SmartLogicUA/GSM-Ringer-Pro/images/gsm_ringer_pro6.jpg

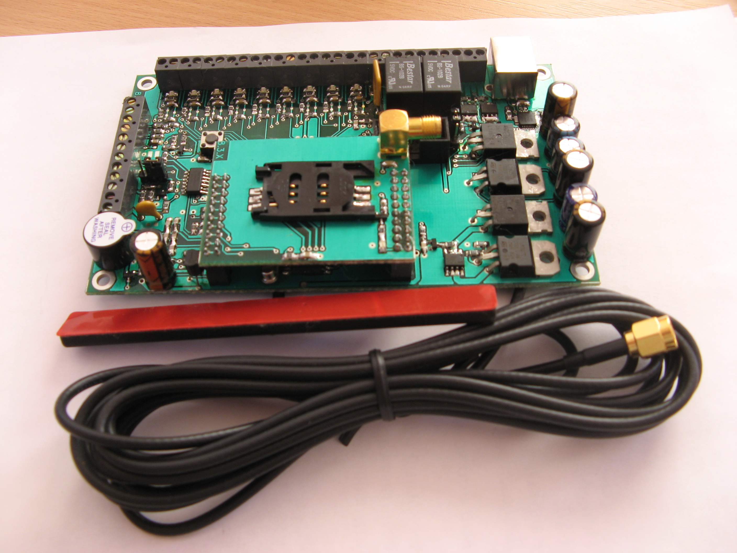
images/gsm_ringer_pro6.jpg
