SmartLogicUA/GSM-Ringer-Pro/images/gsm_ringer_pro3.jpg

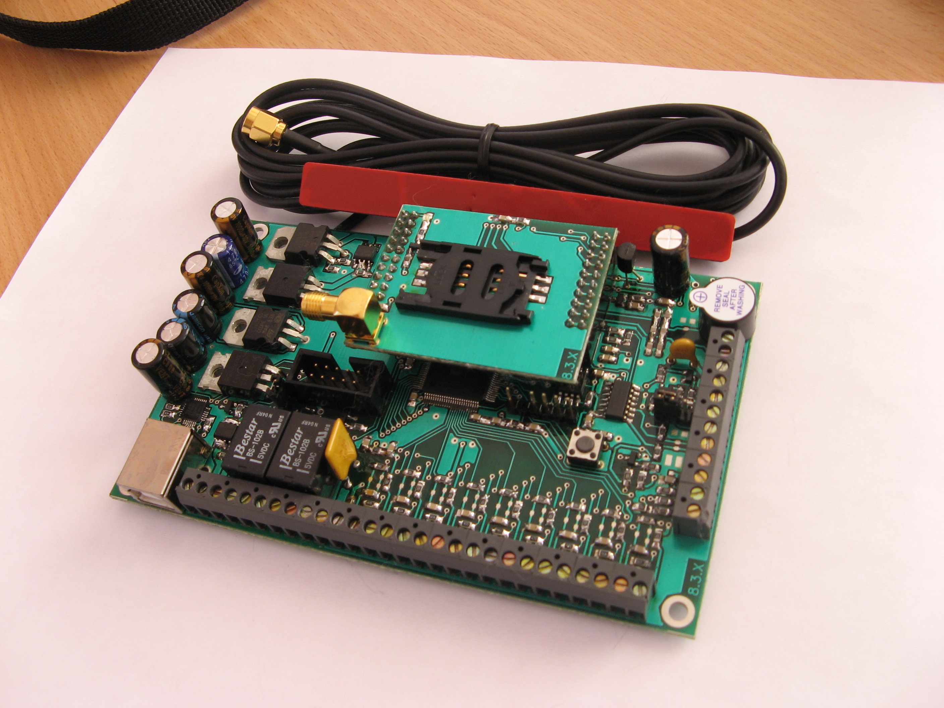
images/gsm_ringer_pro3.jpg
