SmartLogicUA/GSM-Ringer-Pro/bin/gsm_ringer_pro_summary_v1_0_140410.pdf

SMART LOGIC | GSM Ringer Pro v1.0

Устройство GSM оповещения «GSM Ringer Pro» прошивка GSM Ringer Pro v1.0

Контроллер «GSM Ringer Pro» предназначен для оповещения о проникновении посторонних лиц на контролируемые объекты (квартиры, офисы, дачи и др.), посредством дозвона или отправления SMS на указанные телефонные номера по GSM каналу. Контроллер предназначен
для | установки | на | отдельный | объект | и | является
полнофункциональным | устройством. | Он | позволяет
осуществлять контроль доступа на объект при помощи

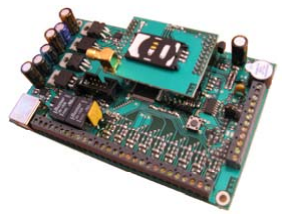
[picture p3: figure]

считывателя proximity-карт и удаленное управление сопрягаемыми с ним устройствами с мобильного терминала при помощи DTMF.
Для построения системы оповещения достаточно применение данного контроллера, датчиков и устройства электропитания. Конструкция контроллера позволяет использовать любые типы датчиков, имеющих нормально-замкнутый или нормально-разомкнутый контакты. При подключении датчиков используются оконечные резисторы. Контроллер является адаптивным устройством с гибкой системой настроек. Для осуществления настройки используется ПК и специализированное программное обеспечение.

Технические возможности «GSM Ringer Pro»:

- работа в сетях GSM – 900/1800/1900;
- световая индикация наличия покрытия оператора связи GSM;
- световая индикация состояния каждой зоны (на плате контроллера и выносная);
- акустическая и световая индикация постановки контроллера в активный режим;
- проверка счета, пополнение счета и т.д.;
- выбор способа оповещения (дозвон и/или сообщение);
- акустический контроль помещения с помощью выносного микрофона;
- активация/деактивация при помощи кнопки, считывателя proximity-карт, посредством мобильного терминала с использованием DTMF;
- максимальное количество прописанных в системе proximity-карточек -20;
- установка времени отсрочки активации контроллера от 1 до 255с;
- установка времени отсрочки оповещения от 1 до 255с;
- программное исключение неиспользуемых зон;
- управление исполнительными устройствами при помощи релейных выходов и выходов с открытым коллектором;
- настройка срабатывания релейных выходов и выходов с открытым коллектором по срабатыванию зон, считывателю, кнопке, получении команды с мобильного терминала с использованием DTMF;
- установка задержки срабатывания и времени удержания релейных выходов и выходов с открытым коллектором;
- максимальное количество телефонных номеров пользователей - 5;
- конфигурирование при помощи SMS сообщения и через USB-порт;
- обновление программного обеспечения контроллера через USB-порт;
- наличие голосового меню;
- установка заводских настроек.

Технические характеристики «GSM Ringer Pro»:

support@smartlogic.com.ua | www.smartlogic.com.ua

SMART LOGIC | GSM Ringer Pro v1.0
- напряжение питания постоянного тока 12В;
- потребляемый ток в дежурном режиме менее 0,15А (без учета потребления считывателя proximity-карт) ;
- интерфейс для подключения считывателя proximity-карт – Wiegand-26;
- максимальное сопротивление постоянному току контролируемого шлейфа не более 150 Ом;
- количество контролируемых шлейфов - 8;
- сопротивление/мощность оконечного резистора - (2,2 ± 5%)/0,125 кОм/Вт;
- количество релейных выходов – 2;
- количество выходов с открытым коллектором -2;
- максимальное коммутируемое релейным выходом переменное/постоянное напряжение – 125/25В;
- максимальный коммутируемый релейным выходом переменный/постоянный ток – 1/2А;
- максимальное коммутируемое выходом с открытым коллектором постоянное напряжение – 15В;
- максимальный коммутируемый выходом с открытым коллектором постоянный ток – 1А;
- диапазон рабочих температур -20 … +60С;
- масса контроллера не более 350г.
| «GSM Ringer Pro - Конфигуратор» предназначен для конфигурирования устройства GSM оповещения «GSM

Ringer Pro».

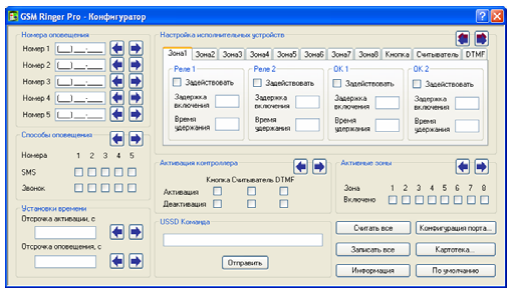
[picture p4: figure]

Возможности:
- установка номеров абонентов;
- установка времени отсрочки активации;
- установка времени отсрочки оповещения;
- выбор способов оповещения;
- выбор активных зон;
- установка срабатывания релейных выходов и выходов с открытым коллектором по внешним событиям;
- установка задержки срабатывания и времени удержания релейных выходов и выходов с открытым коллектором;
- прописывание/стирание proximity-карт в контроллер;
- установка параметров по умолчанию;
- выполнение USSD команд.

В состав «GSM Ringer Pro» входят:
- устройство «GSM Ringer Pro»;
- GSM антенна;
- модуль индикации;
- программное обеспечение.
support@smartlogic.com.ua | www.smartlogic.com.ua
