SmartLogicUA/GSM-Ringer-Pro/images/gsm_ringer_pro1.jpg

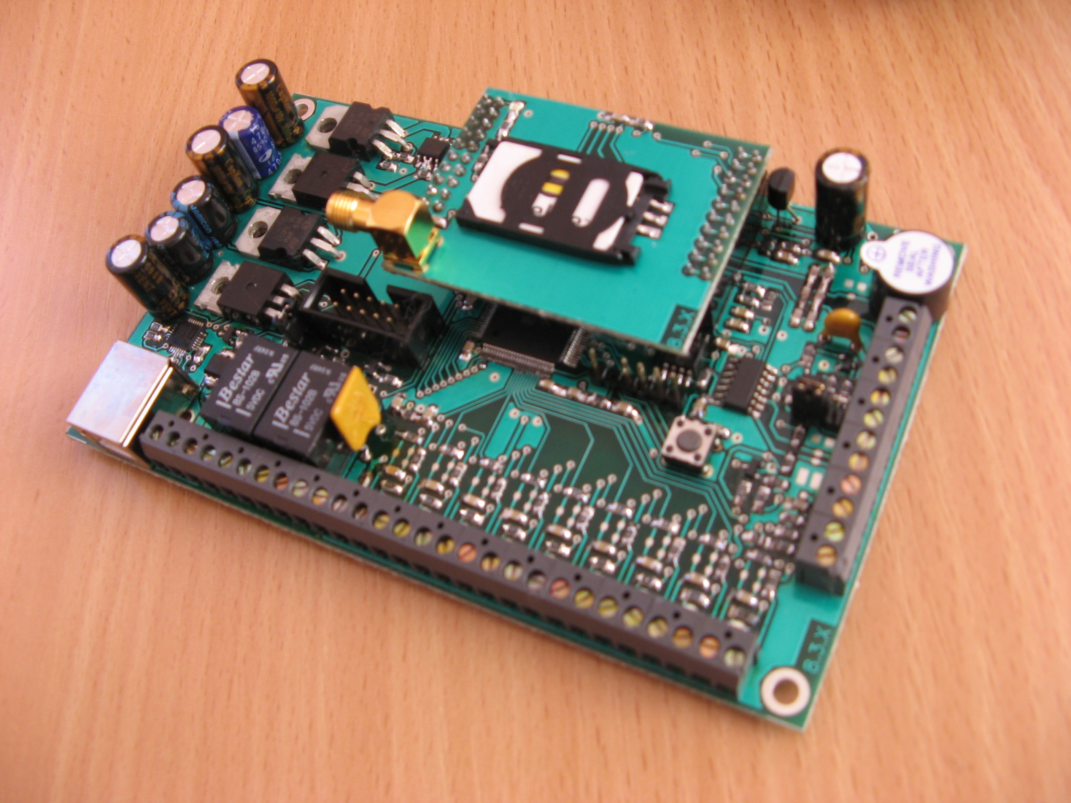
images/gsm_ringer_pro1.jpg
