SmartLogicUA/GSM-Ringer-Pro/images/gsm_ringer_pro2.jpg

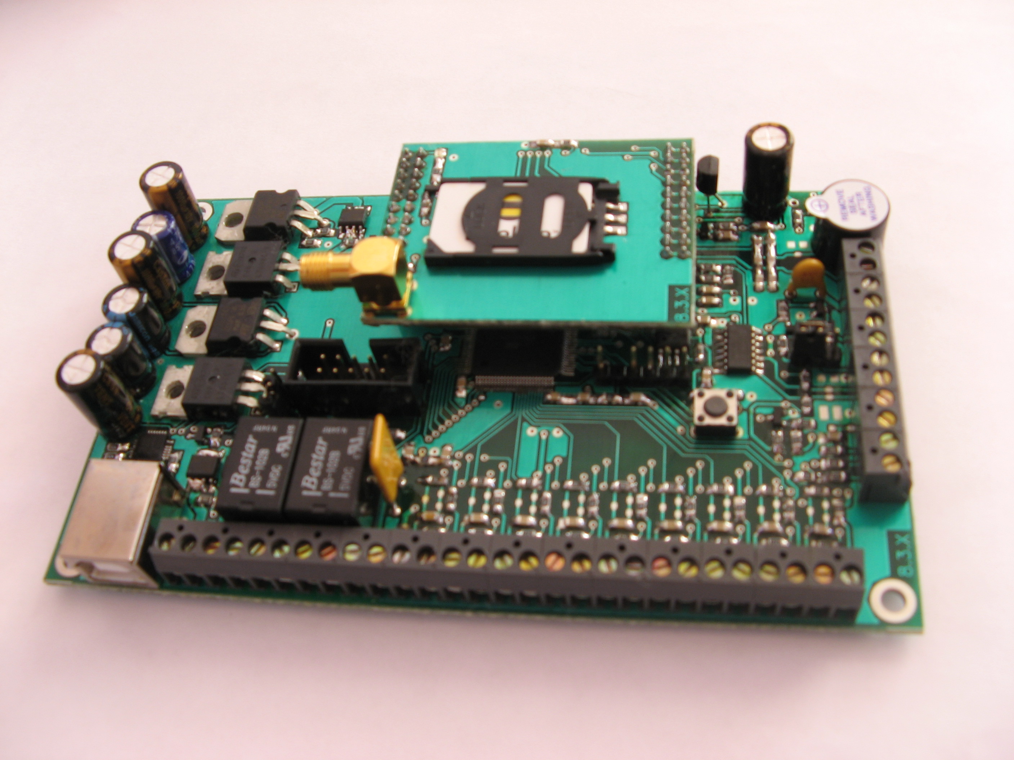
images/gsm_ringer_pro2.jpg
