SmartLogicUA/GSM-Ringer-Pro/images/gsm_ringer_pro4.jpg

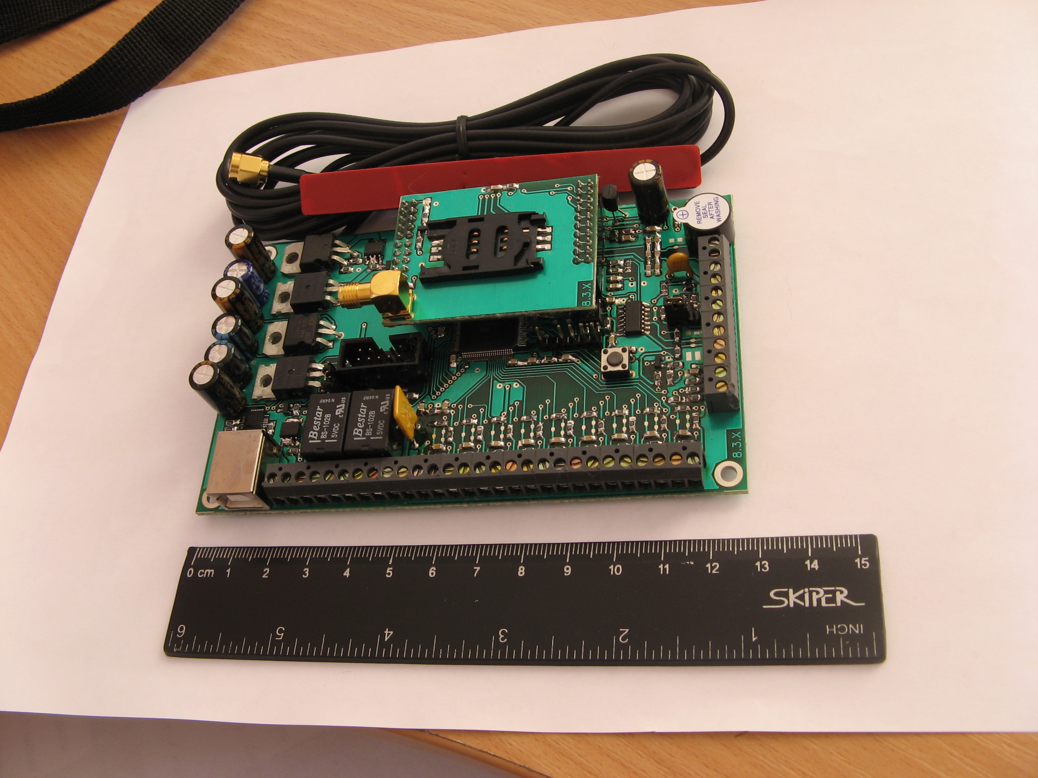
images/gsm_ringer_pro4.jpg
