SmartLogicUA/GSM-Ringer-Pro/images/gsm_ringer_pro5.jpg

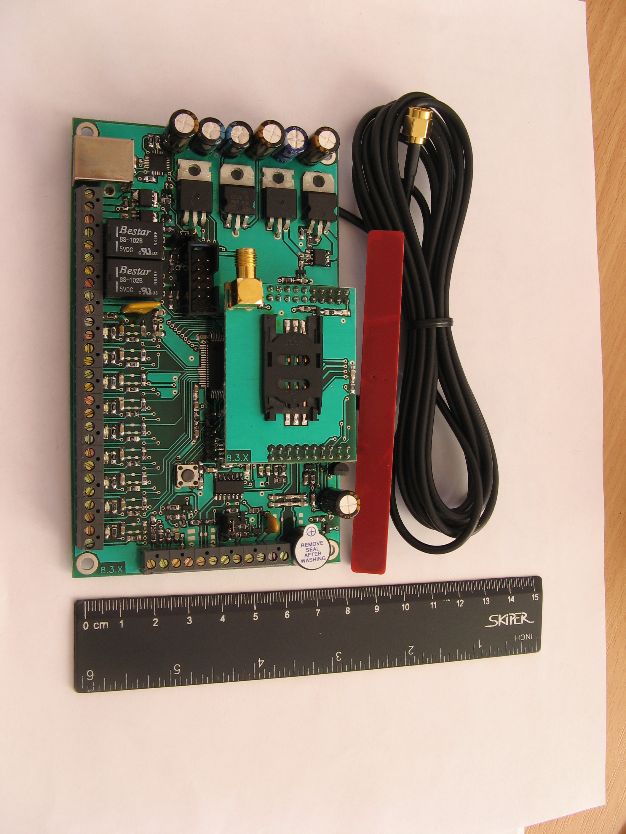
images/gsm_ringer_pro5.jpg
