SmartLogicUA/GSM-Ringer-Pro/images/gsm_ringer_pro.jpg

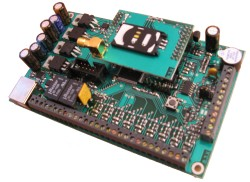
images/gsm_ringer_pro.jpg
