SmartLogicUA/GSM-Ringer-Pro/images/gsm_ringer_pro_box1.jpg

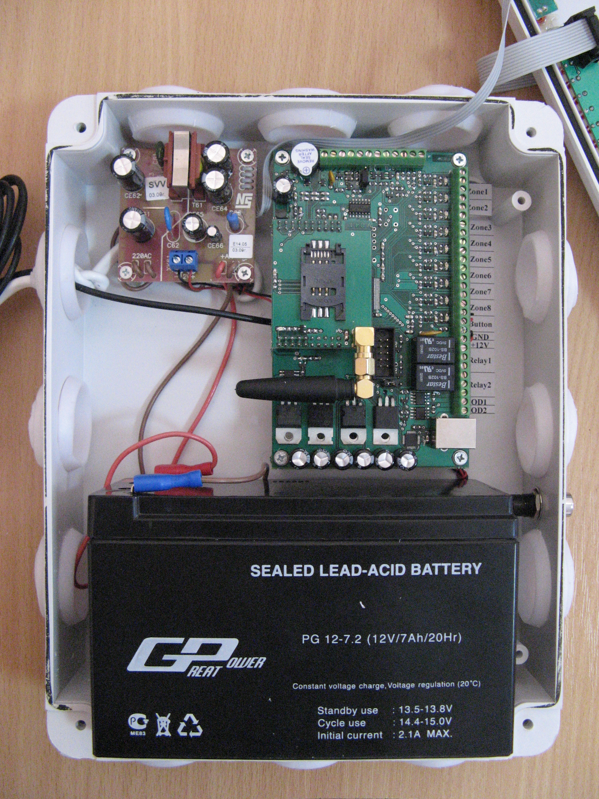
images/gsm_ringer_pro_box1.jpg
