SmartLogicUA/GSM-Ringer-Pro/images/gsm_ringer_pro_box.jpg

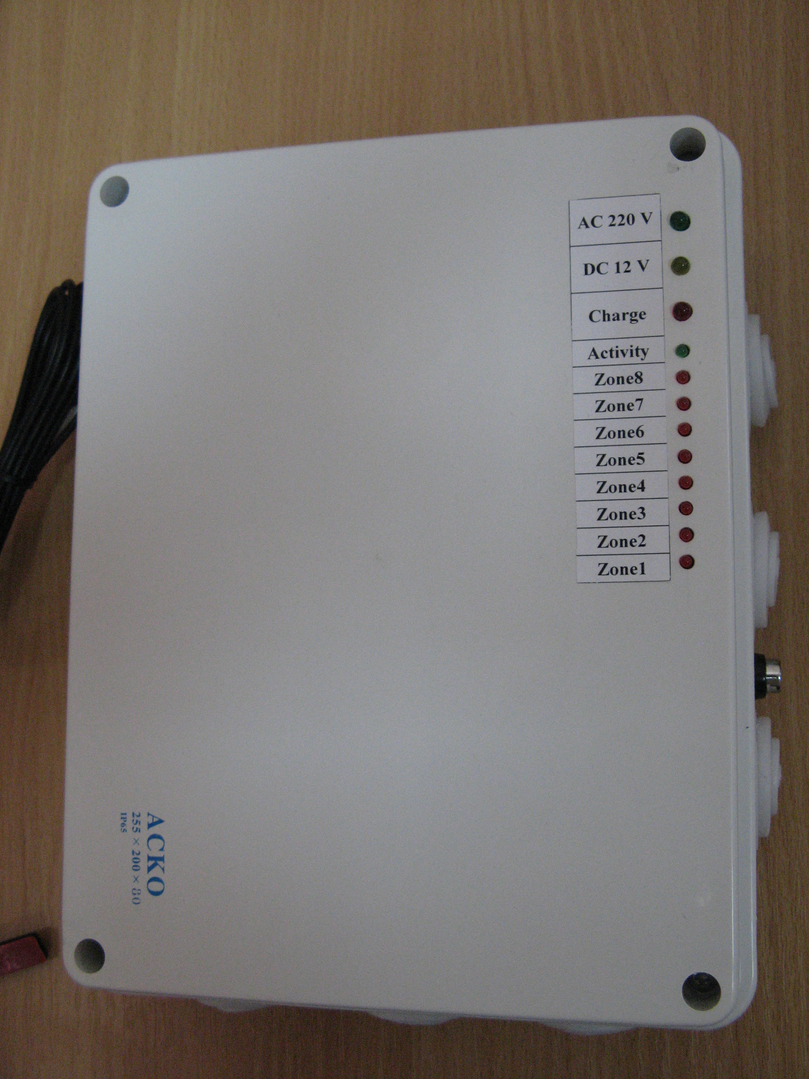
images/gsm_ringer_pro_box.jpg
