SmartLogicUA/GSM-Ringer-Pro/(list of files, drawings)

Other design files:
scheme/v8_3_x/PCAD/v8.3.X_mont.pcb
scheme/v8_3_x/PIC/Prelimiary.PCB
scheme/v8_3_x/PIC/v8.3.1_TOP1.PCB
scheme/v8_3_x/PIC/v8.3.X_BOT2.PCB
scheme/v8_3_x/PIC/v8.3.X_BOT3.PCB
scheme/v8_3_x/PIC/v8.3.X_TOP1.PCB
scheme/v8_3_x/PIC/v8.3.X_TOP2.PCB
scheme/v8_3_x/PIC/v8.3.X_TOP3.PCB
